IanCavalluzzi/Leviathan-Space-Debris-Collector/(commit log)

2026-11-08 Publish Leviathan prototype software, firmware, tests, and setup docs
2026-11-10 Replace README cover with upright prototype photo
2026-11-10 Use the spread-finger prototype photo on the README
